icepixie071/Tracer_ECU_KiCad/(commit log)

2026-01-02 add files.
    [Tracer_ECU.kicad_pcb, Tracer_ECU.kicad_sch]
2026-01-04 PCBレイヤーの不可視化を修正(kicad7.0で開いたことが原因か）
    [Tracer_ECU.kicad_pcb]
2026-01-04 RX72T追加 周辺回路作成中．
    [Tracer_ECU.kicad_sch]
2026-01-26 ゲートドライバを変更
    [Tracer_ECU.kicad_pcb, Tracer_ECU.kicad_sch]
2026-02-01 配線途中をコミット
    [Tracer_ECU.kicad_pcb]
2026-02-10 SPI系配線完了
    [Tracer_ECU.kicad_pcb, Tracer_ECU.kicad_sch]
2026-04-05 ・未配線数０まで完了
    [Tracer_ECU.kicad_pcb, Tracer_ECU.kicad_sch]
2026-04-05 ・大電流GNDビア修正
    [Tracer_ECU.kicad_pcb, Tracer_ECU.kicad_sch]
2026-04-06 ・微修正完了 ・JLCPCB発注完了
    [Tracer_ECU.kicad_pcb]
2026-05-04 ・初回試作基板の動作を踏まえ，TODO欄に修正箇所を追記． ・PCBアートワーク検討中．
    [Tracer_ECU.kicad_pcb, Tracer_ECU.kicad_sch]
2026-05-04 初回製造基板(ver.1.0.1)から下記修正． ・シャント用ADCピン割変更．(PGA無しポート割り当てミス修正） ・ゲートドライバAGNDをフローティング→AGNDに接続． ・SBD型番指定，フットプリント変更． ・PchSW FET ピンコンパチ8A→60A品へ変更． ・スナバCをSMD化，多並列化（合計440uF）． ・DRV8320 C_VMを22u→10uF，2012M→1608Mへ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
    [Tracer_ECU.kicad_pcb, Tracer_ECU.kicad_sch]
2026-05-11 PCBレイアウト修正
    [Tracer_ECU.kicad_pcb]
2026-06-06 JLCPCB tool kitを追加
2026-06-12 回路修正完了(2相/3相選択版) 小型化のため最小ビア径0.45mm/最小配線幅0.2mmへ変更 レイアウト修正8割方完了．一旦コミット
    [Tracer_ECU.kicad_pcb, Tracer_ECU.kicad_sch]
2026-06-18 アートワーク修正中． デバッグコネクタ周辺抵抗を1005M*4抵抗アレイに変更．
    [Tracer_ECU.kicad_pcb, Tracer_ECU.kicad_sch]
2026-06-22 DCバイアスを考慮しパワーＣサイズを変更． アートワーク修正中．
    [Tracer_ECU.kicad_pcb, Tracer_ECU.kicad_sch]
2026-07-01 PCB配線完了.(未配線ゼロ)
    [Tracer_ECU.kicad_pcb, Tracer_ECU.kicad_sch]
2026-07-03 バスバー用銅箔追加 レイアウト微調整
    [Tracer_ECU.kicad_pcb]
2026-07-04 LCD用ポートコネクタを追加．(I2C端子)
    [Tracer_ECU.kicad_pcb, Tracer_ECU.kicad_sch]
2026-07-04 アートワーク微修正．
    [Tracer_ECU.kicad_pcb]
2026-07-05 productionフォルダ管理対象に追加．
    [Tracer_ECU.kicad_pcb, bom.csv, designators.csv, positions.csv]
2026-07-05 レイアウト微修正．製造ファイル生成，発注完了．
    [Tracer_ECU.kicad_pcb, bom.csv, designators.csv, positions.csv]
2026-10-16 プロジェクト設定更新．
2026-10-16 電流センス回路フィルタ用集合Ｒ変更 4.7k → 470
2026-11-01 一部ルーティングを微修正．
2026-11-09 電流センス回路の定数を更新．
